perc-sw/phyduino_pico/docs/pdf/board/pinouts.pdf

# PHYDUINO PICO PIN OUTS

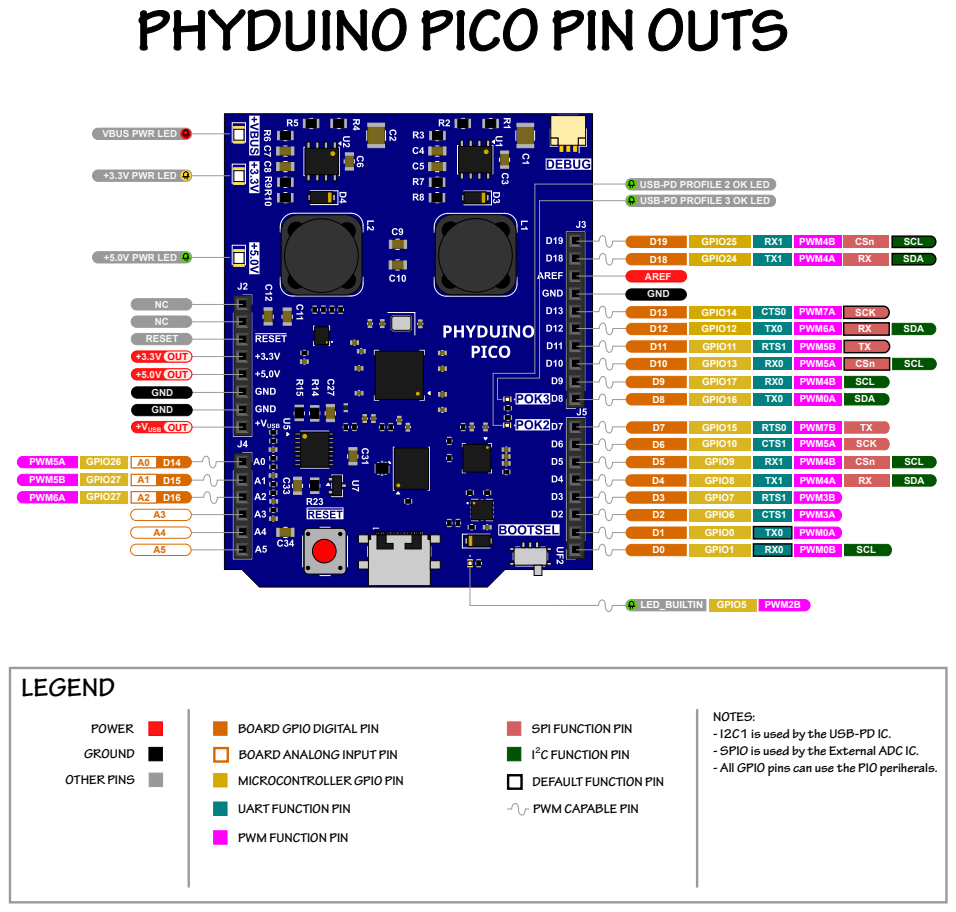
[picture p2: page 1]

USB-PD PROFILE 2 OK LED
USB-PD PROFILE 3 OK LED

NOTES:
- I2C1 is used by the USB-PD IC.
- SPI0 is used by the External ADC IC.
- All GPIO pins can use the PIO periherals.

BOARD GPIO DIGITAL PIN

BOARD ANALONG INPUT PIN
MICROCONTROLLER GPIO PIN
