perc-sw/phyduino_pico/docs/pdf/board/phyduino_pico_schematic.pdf

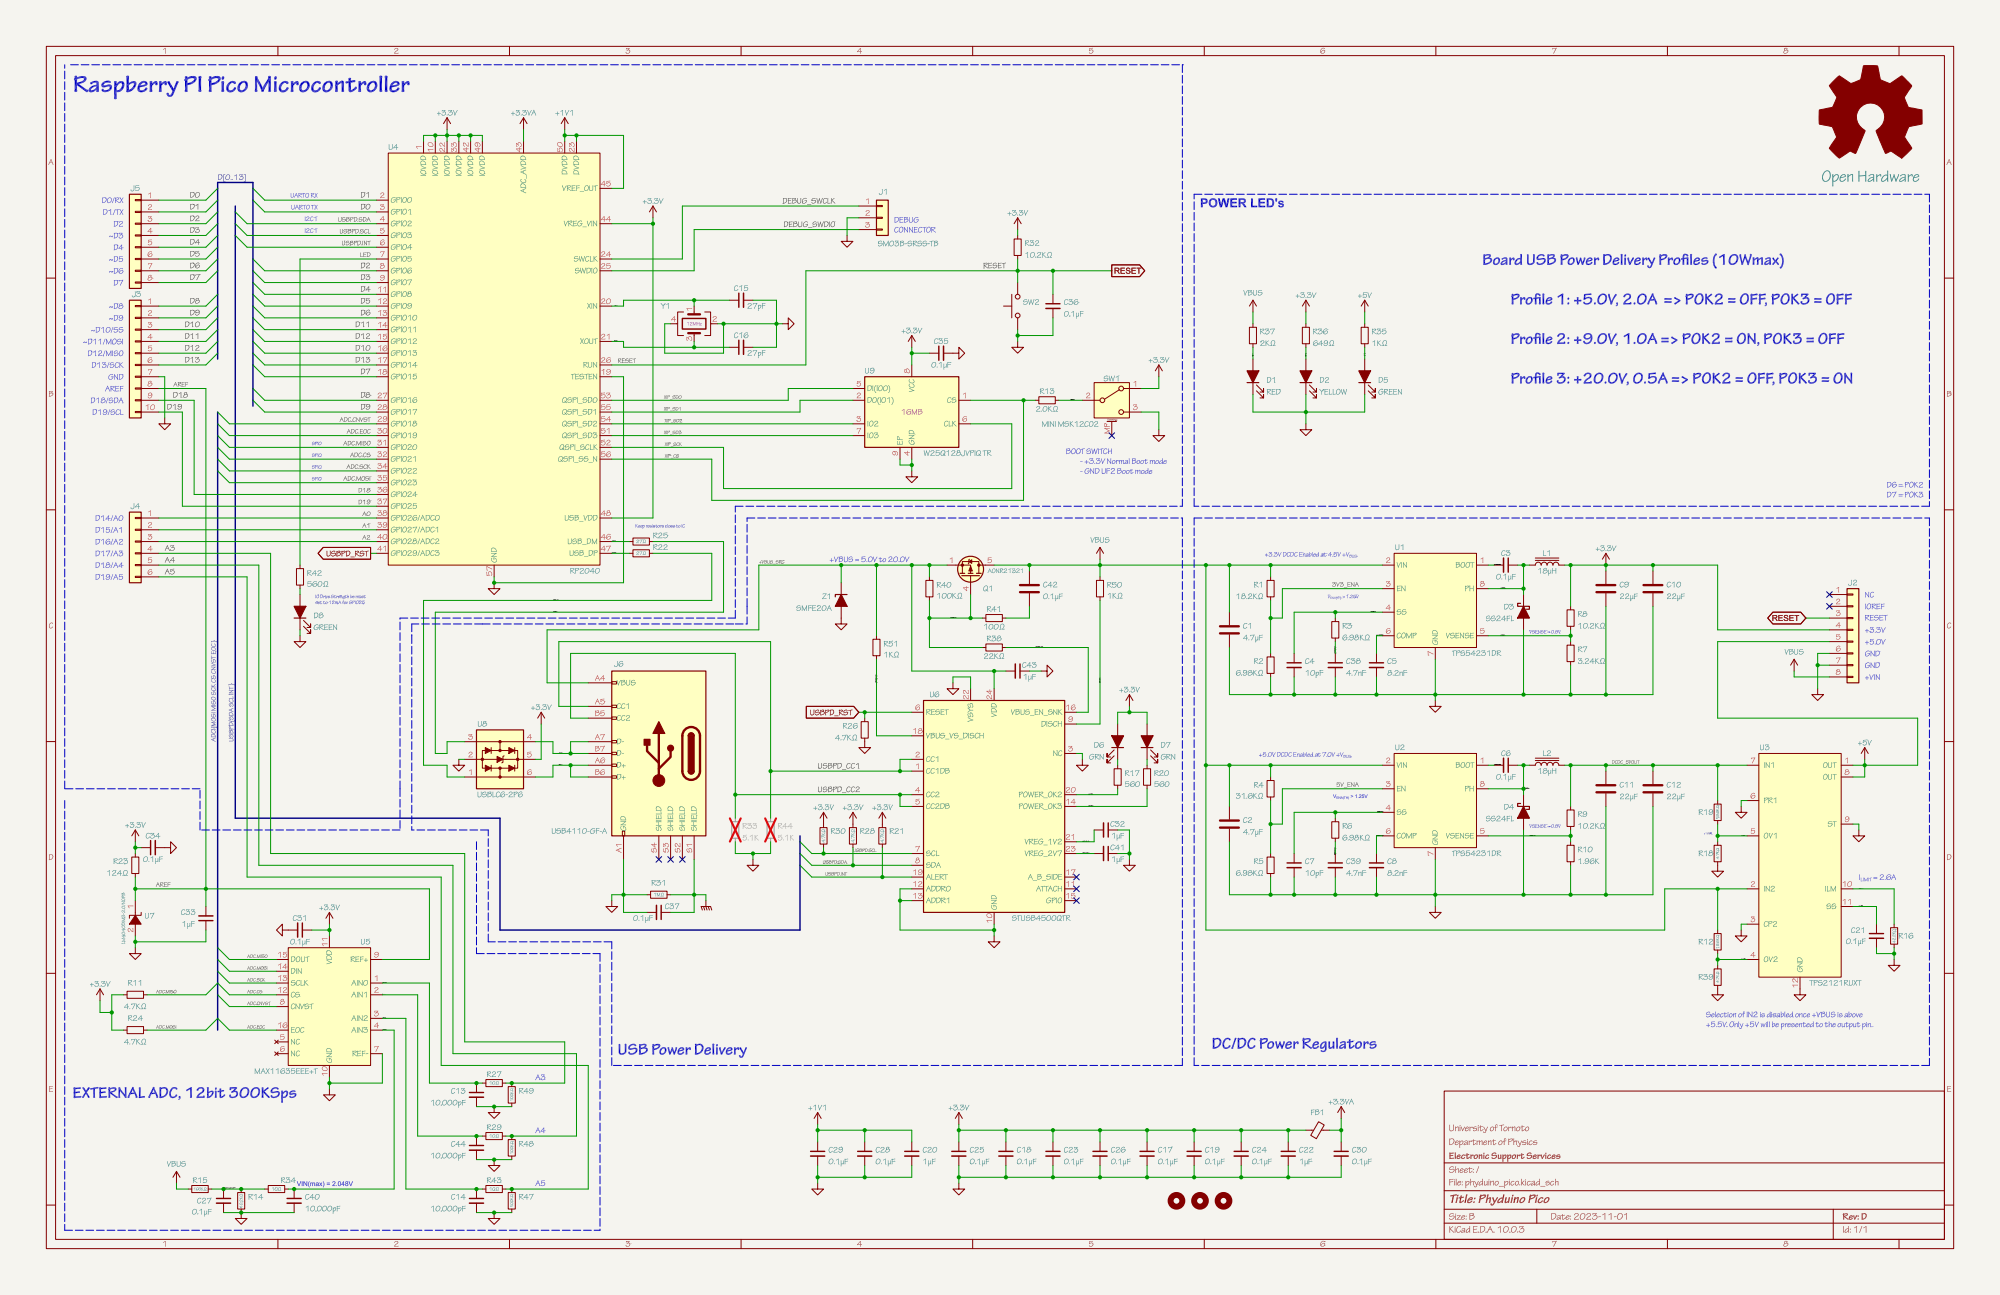
[picture p3: page 1]
