perc-sw/phyduino_pico/docs/pdf/board/phyduino_pico_pcb_back.pdf

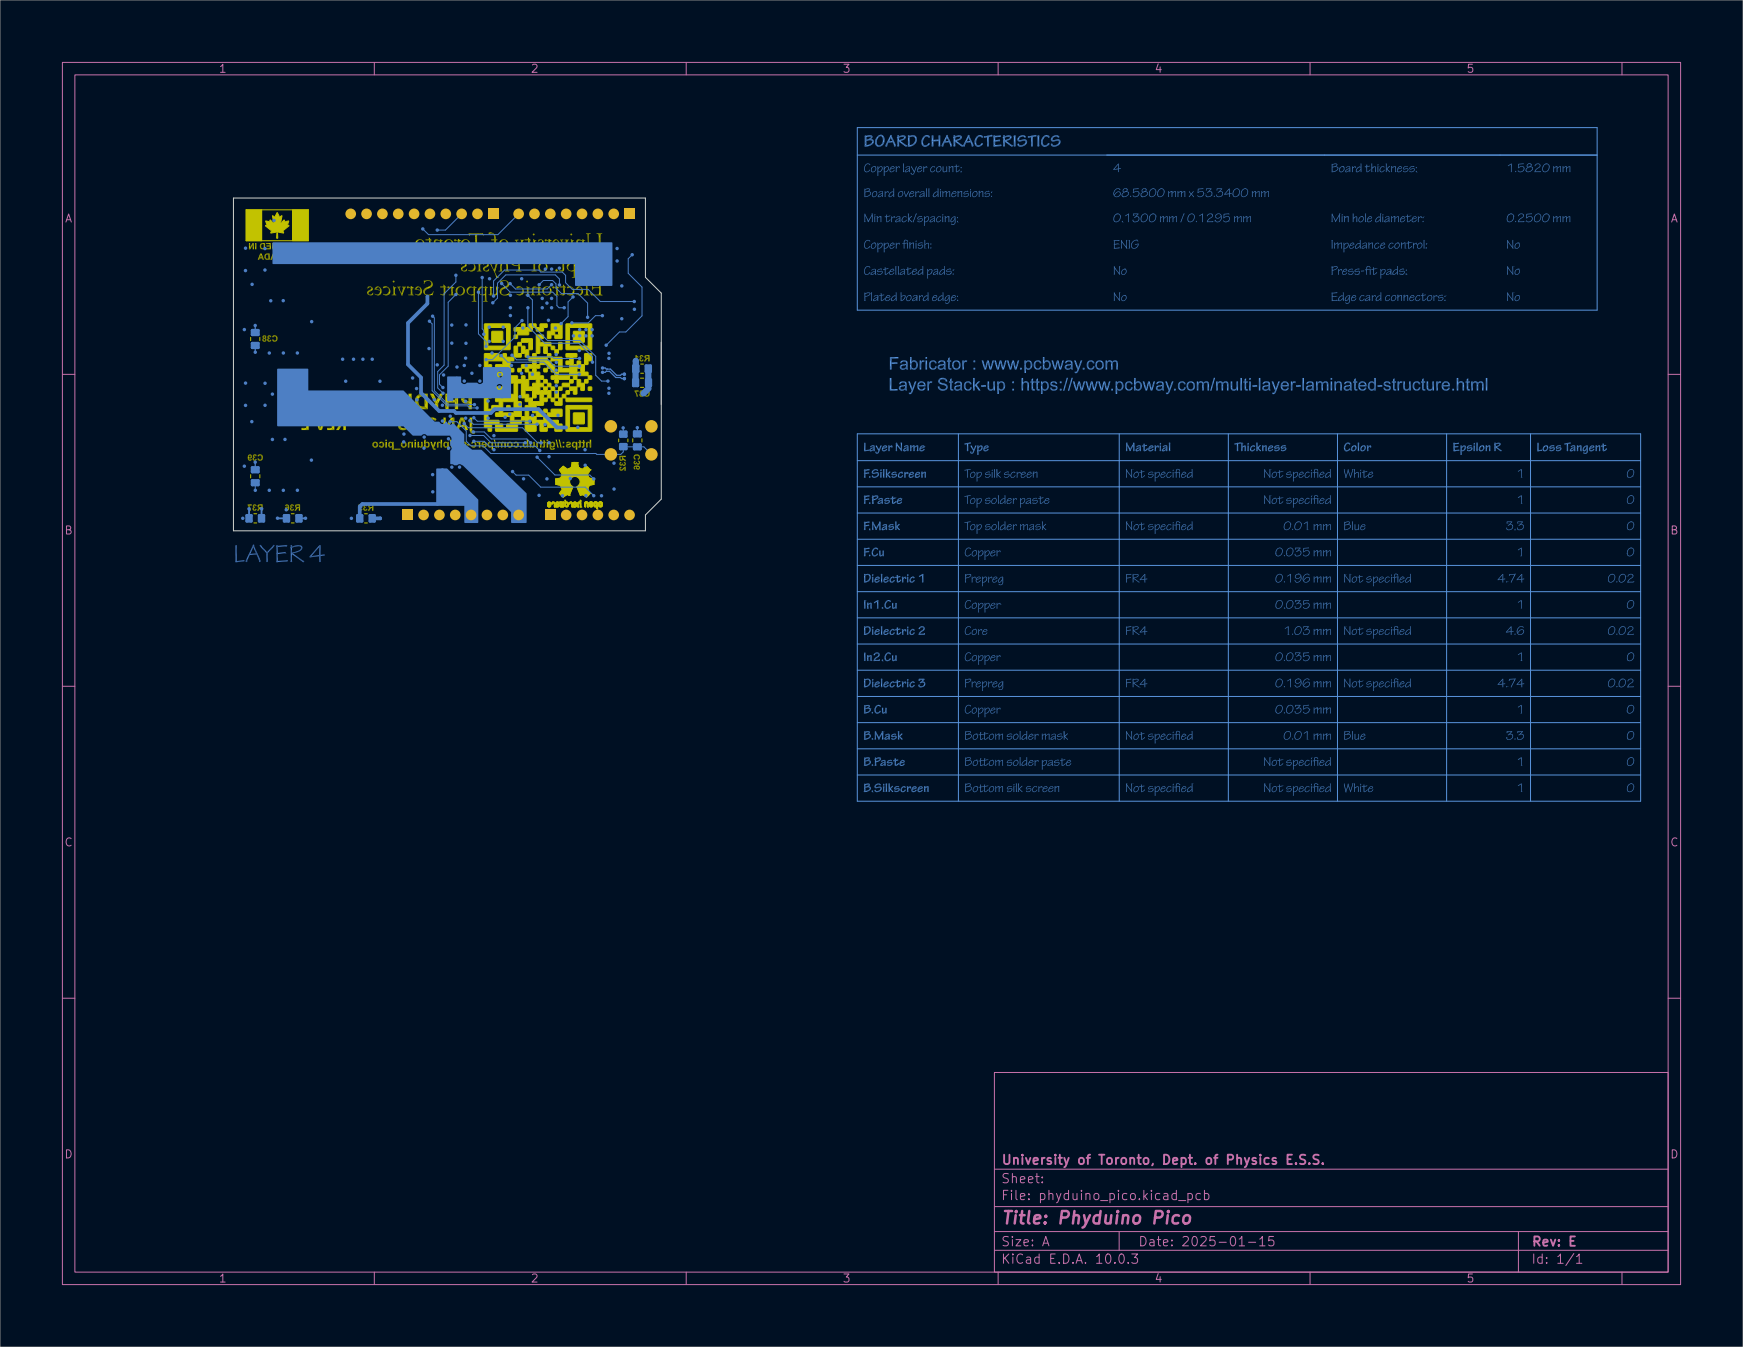
[picture p4: page 1]
