perc-sw/phyduino_pico/docs/pdf/board/phyduino_pico_pcb_front.pdf

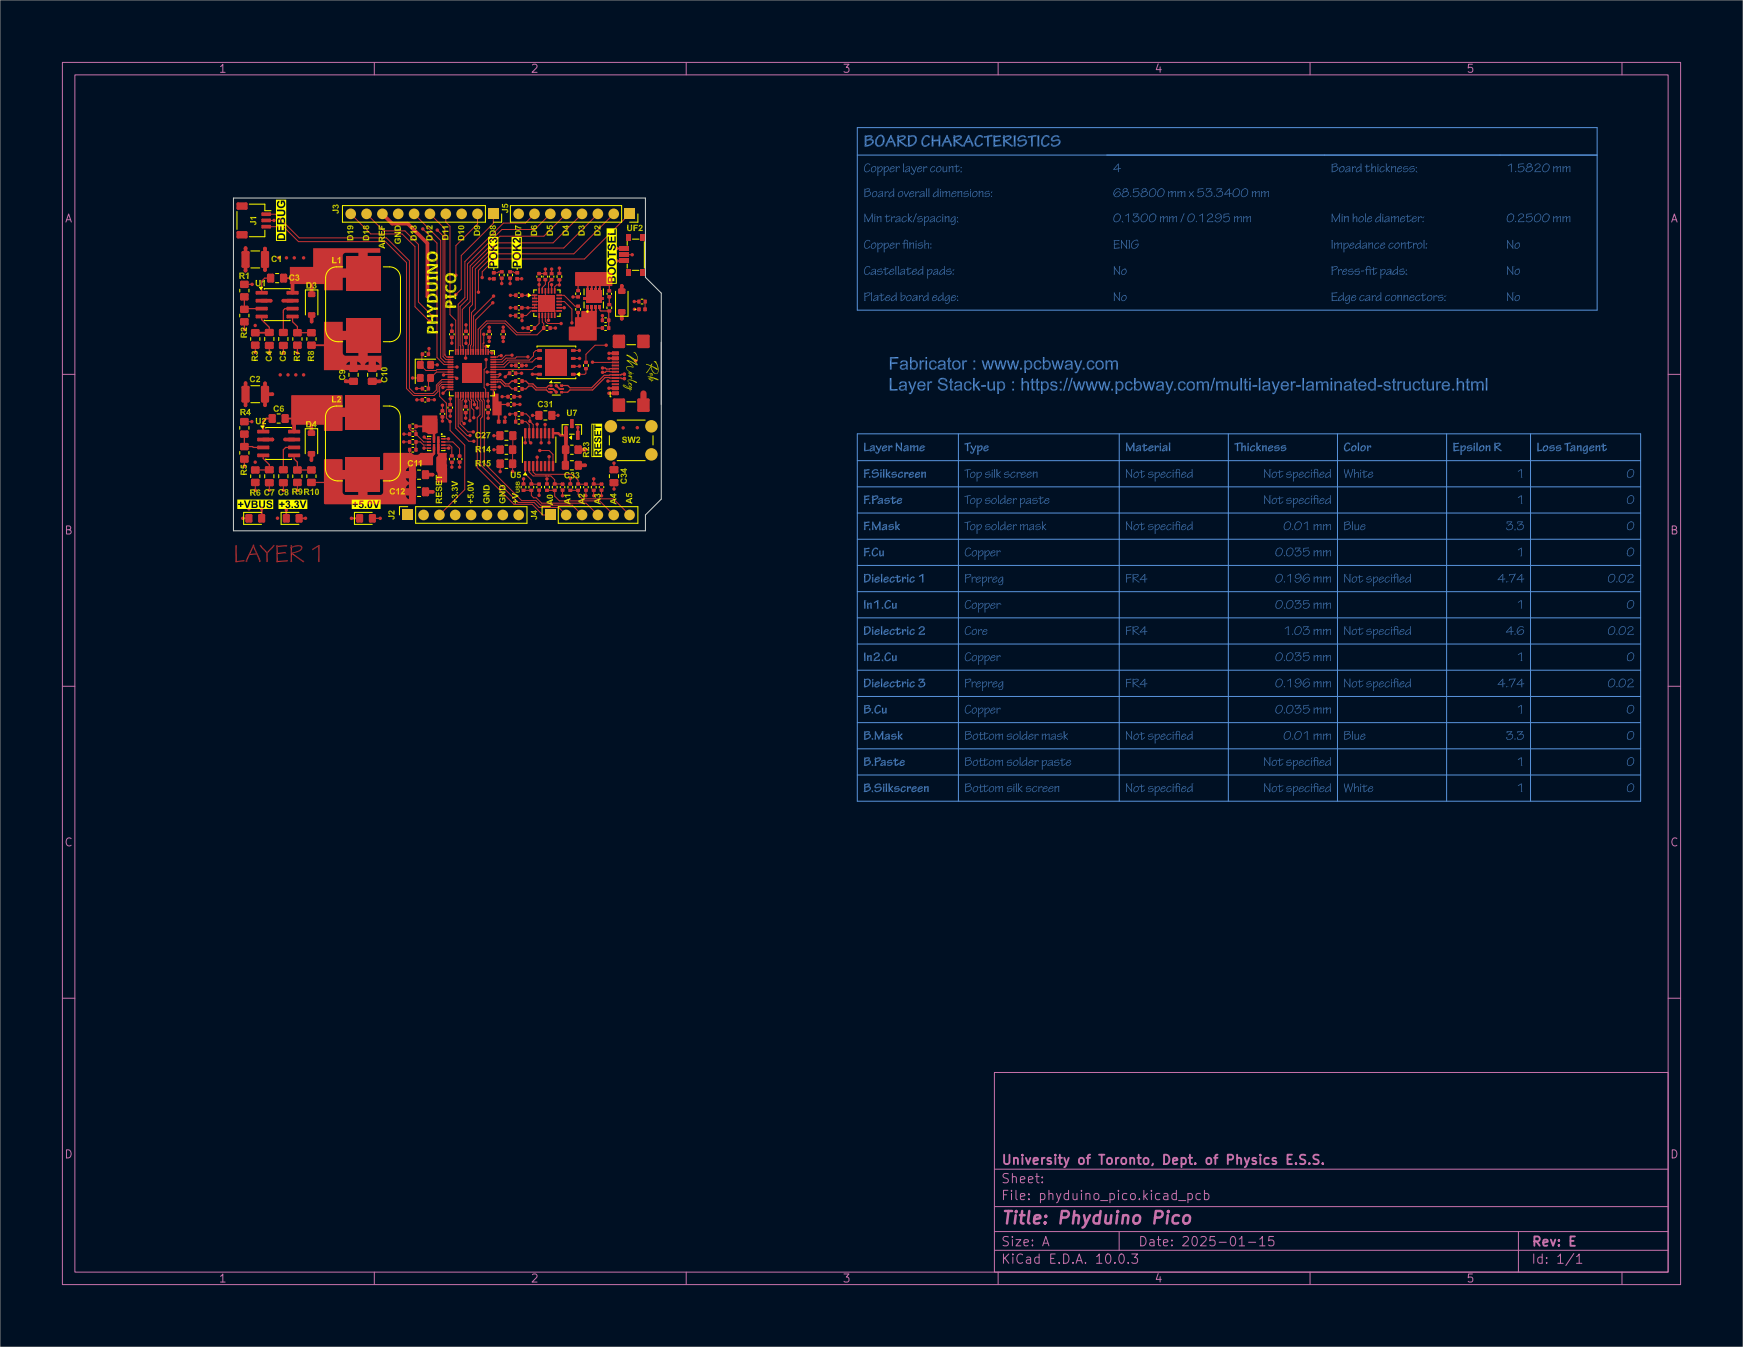
[picture p5: page 1]
