perc-sw/phyduino_pico/docs/pdf/board/phyduino_pico_pcb_inner1.pdf

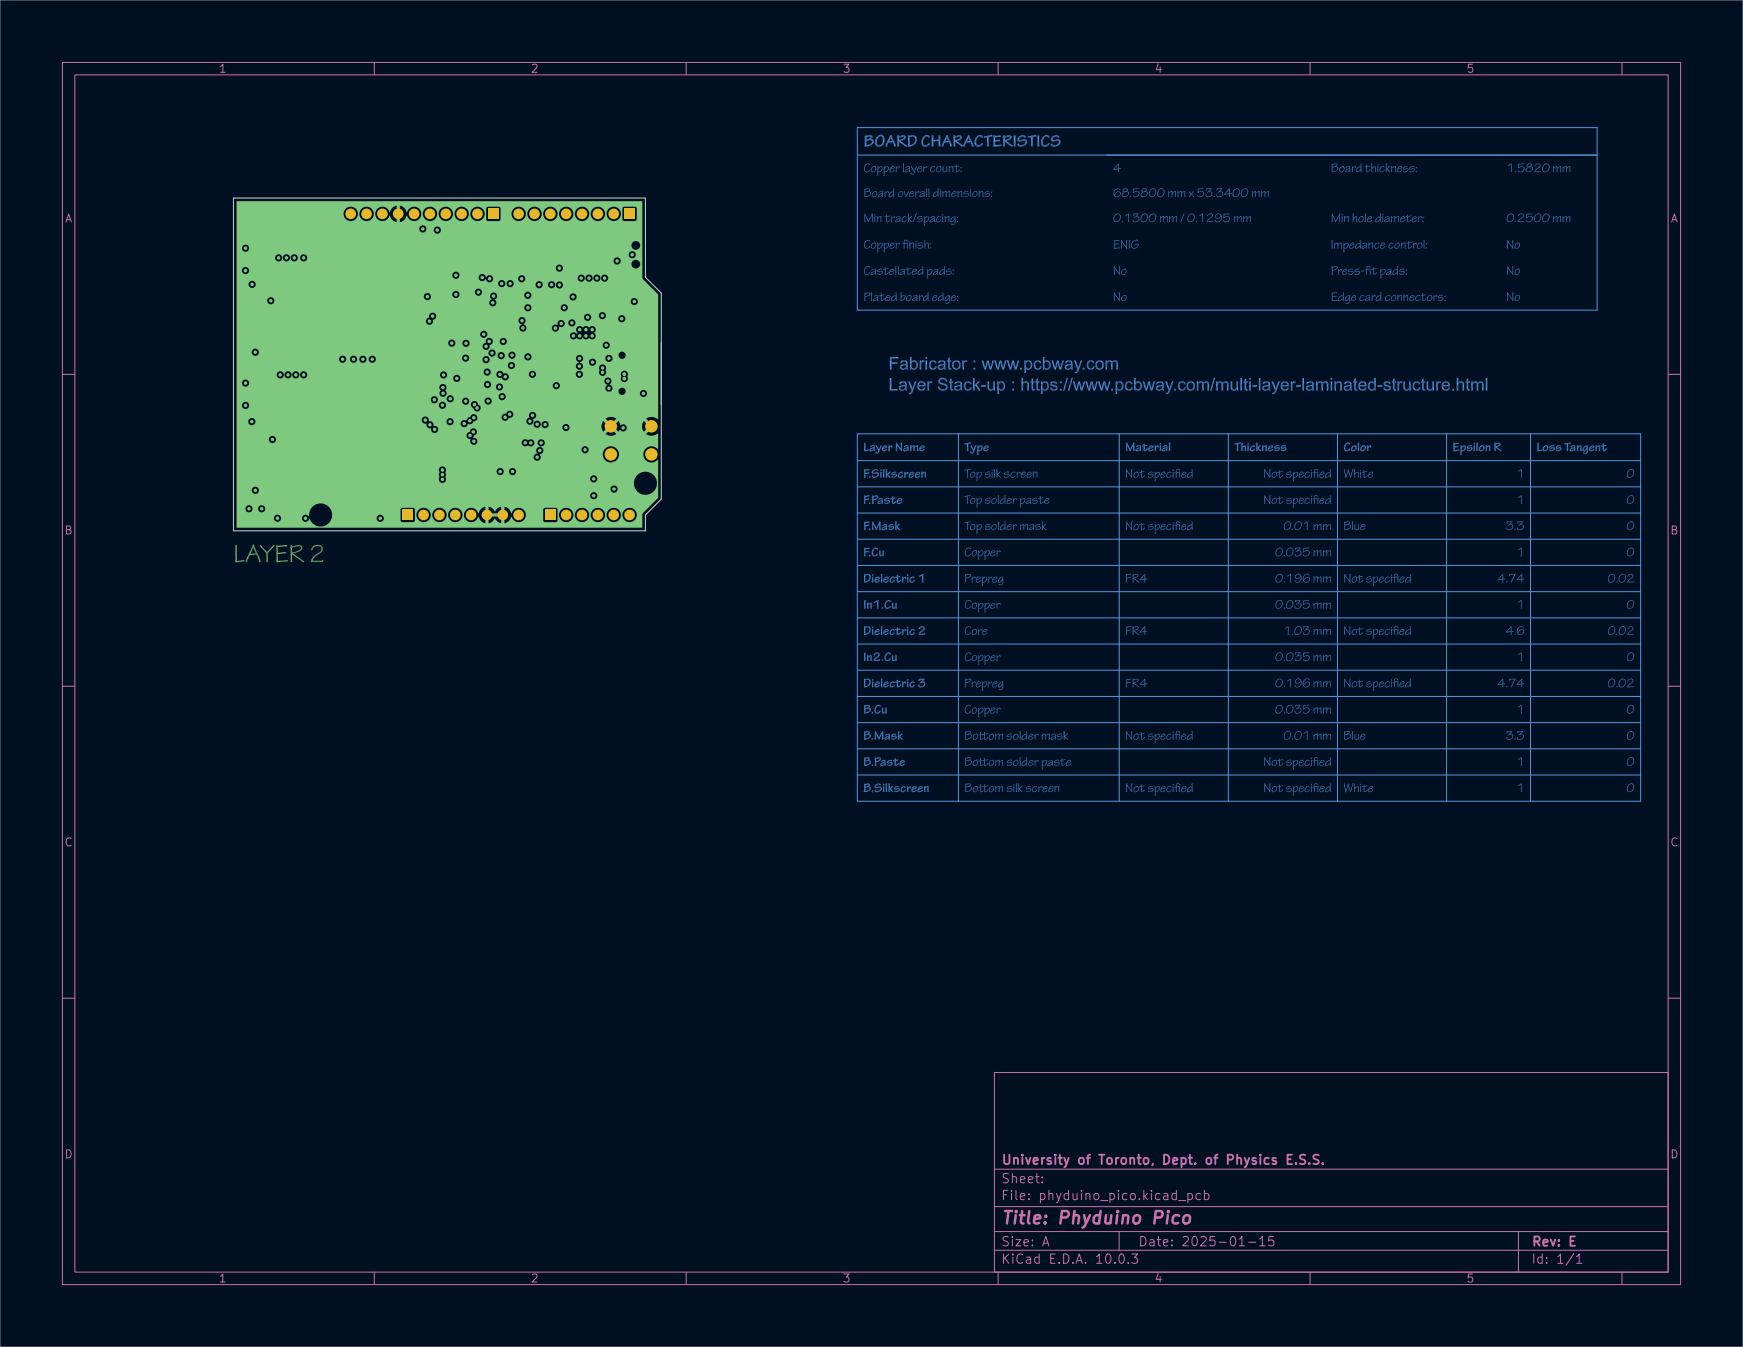
[picture p6: page 1]
