perc-sw/phyduino_pico/docs/pdf/board/phyduino_pico_pcb_inner2.pdf

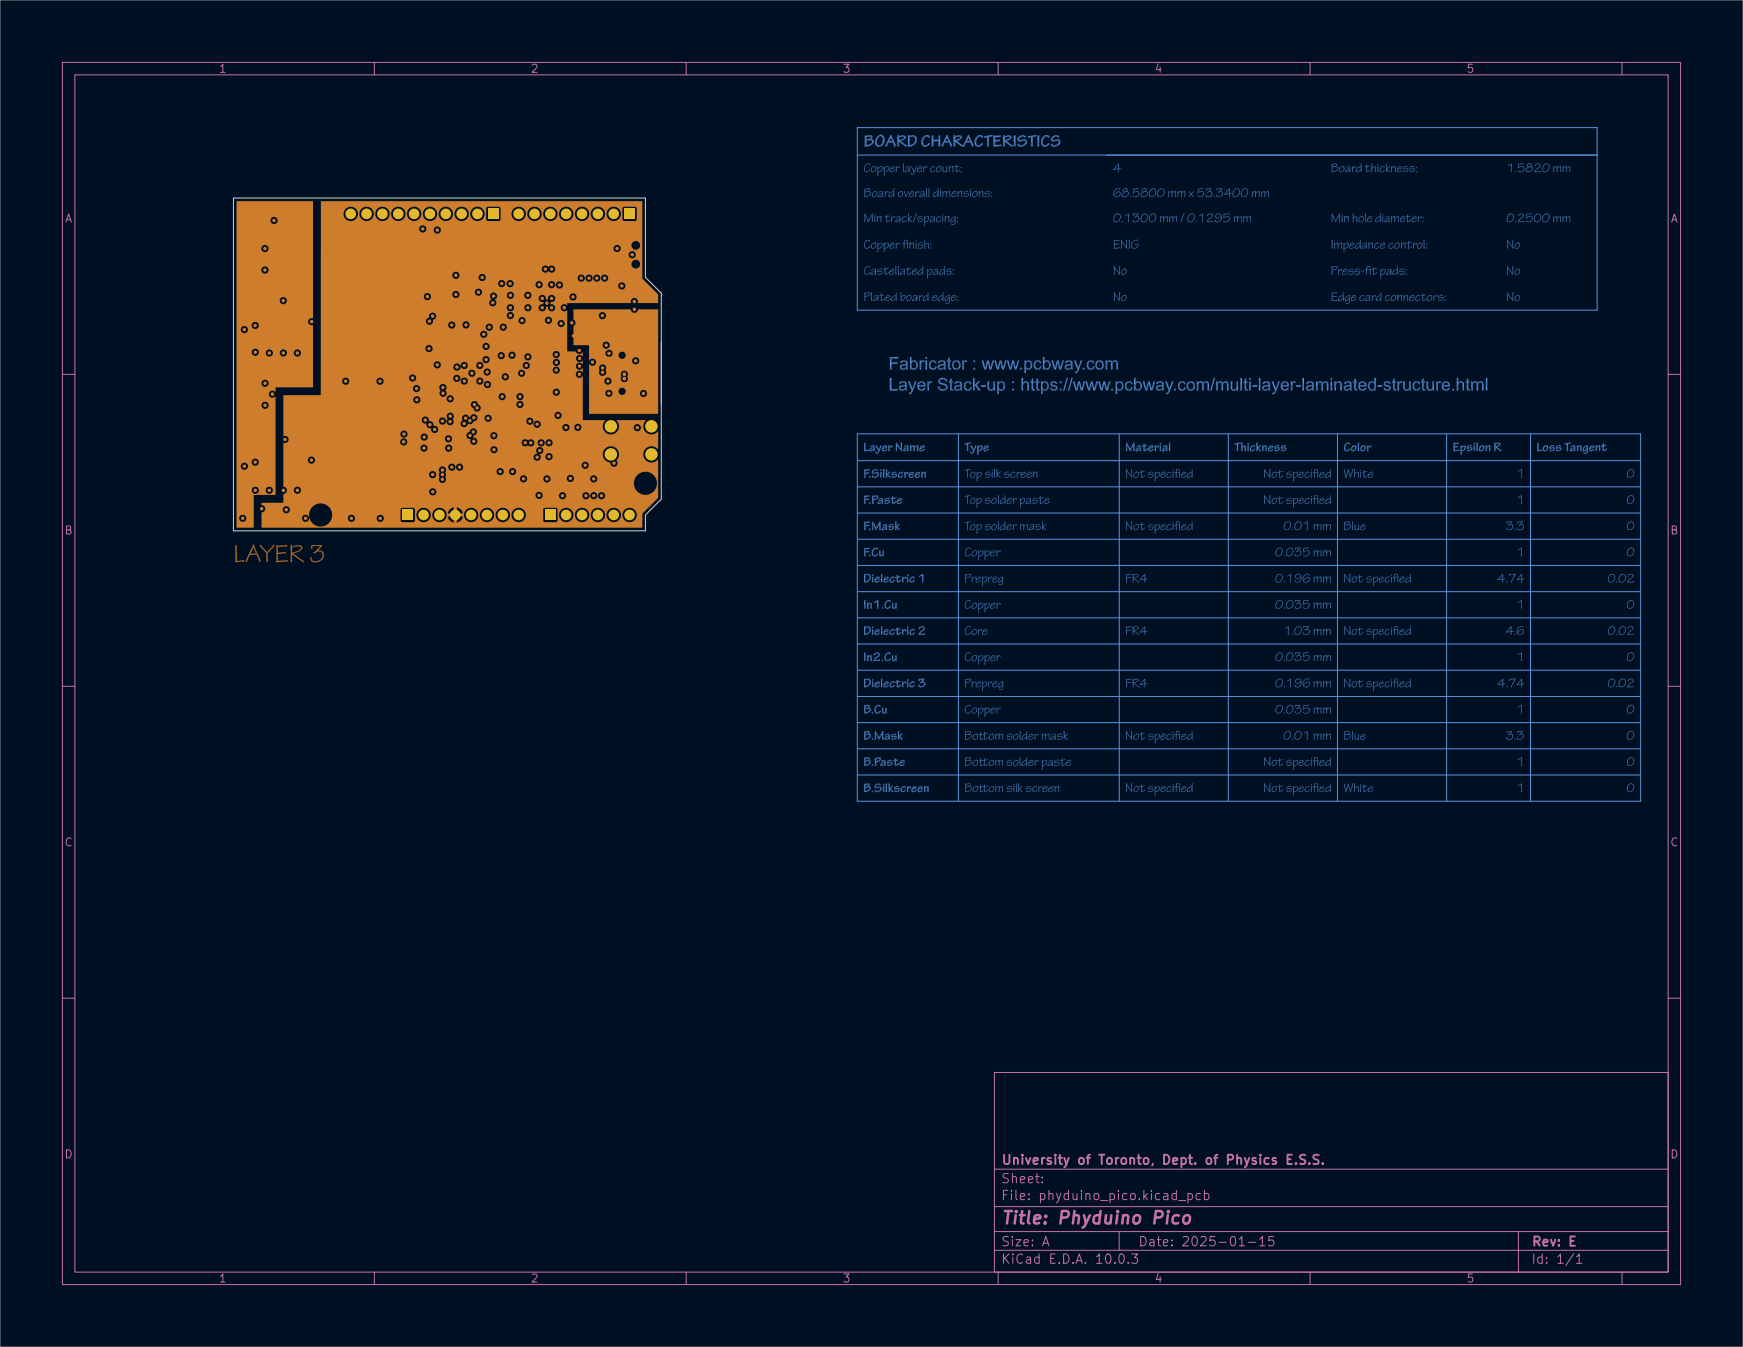
[picture p7: page 1]
