perc-sw/phyduino_pico/phyduino_pico.kicad_sch

## KiCad design phyduino_pico.kicad_sch (2026-06-09)

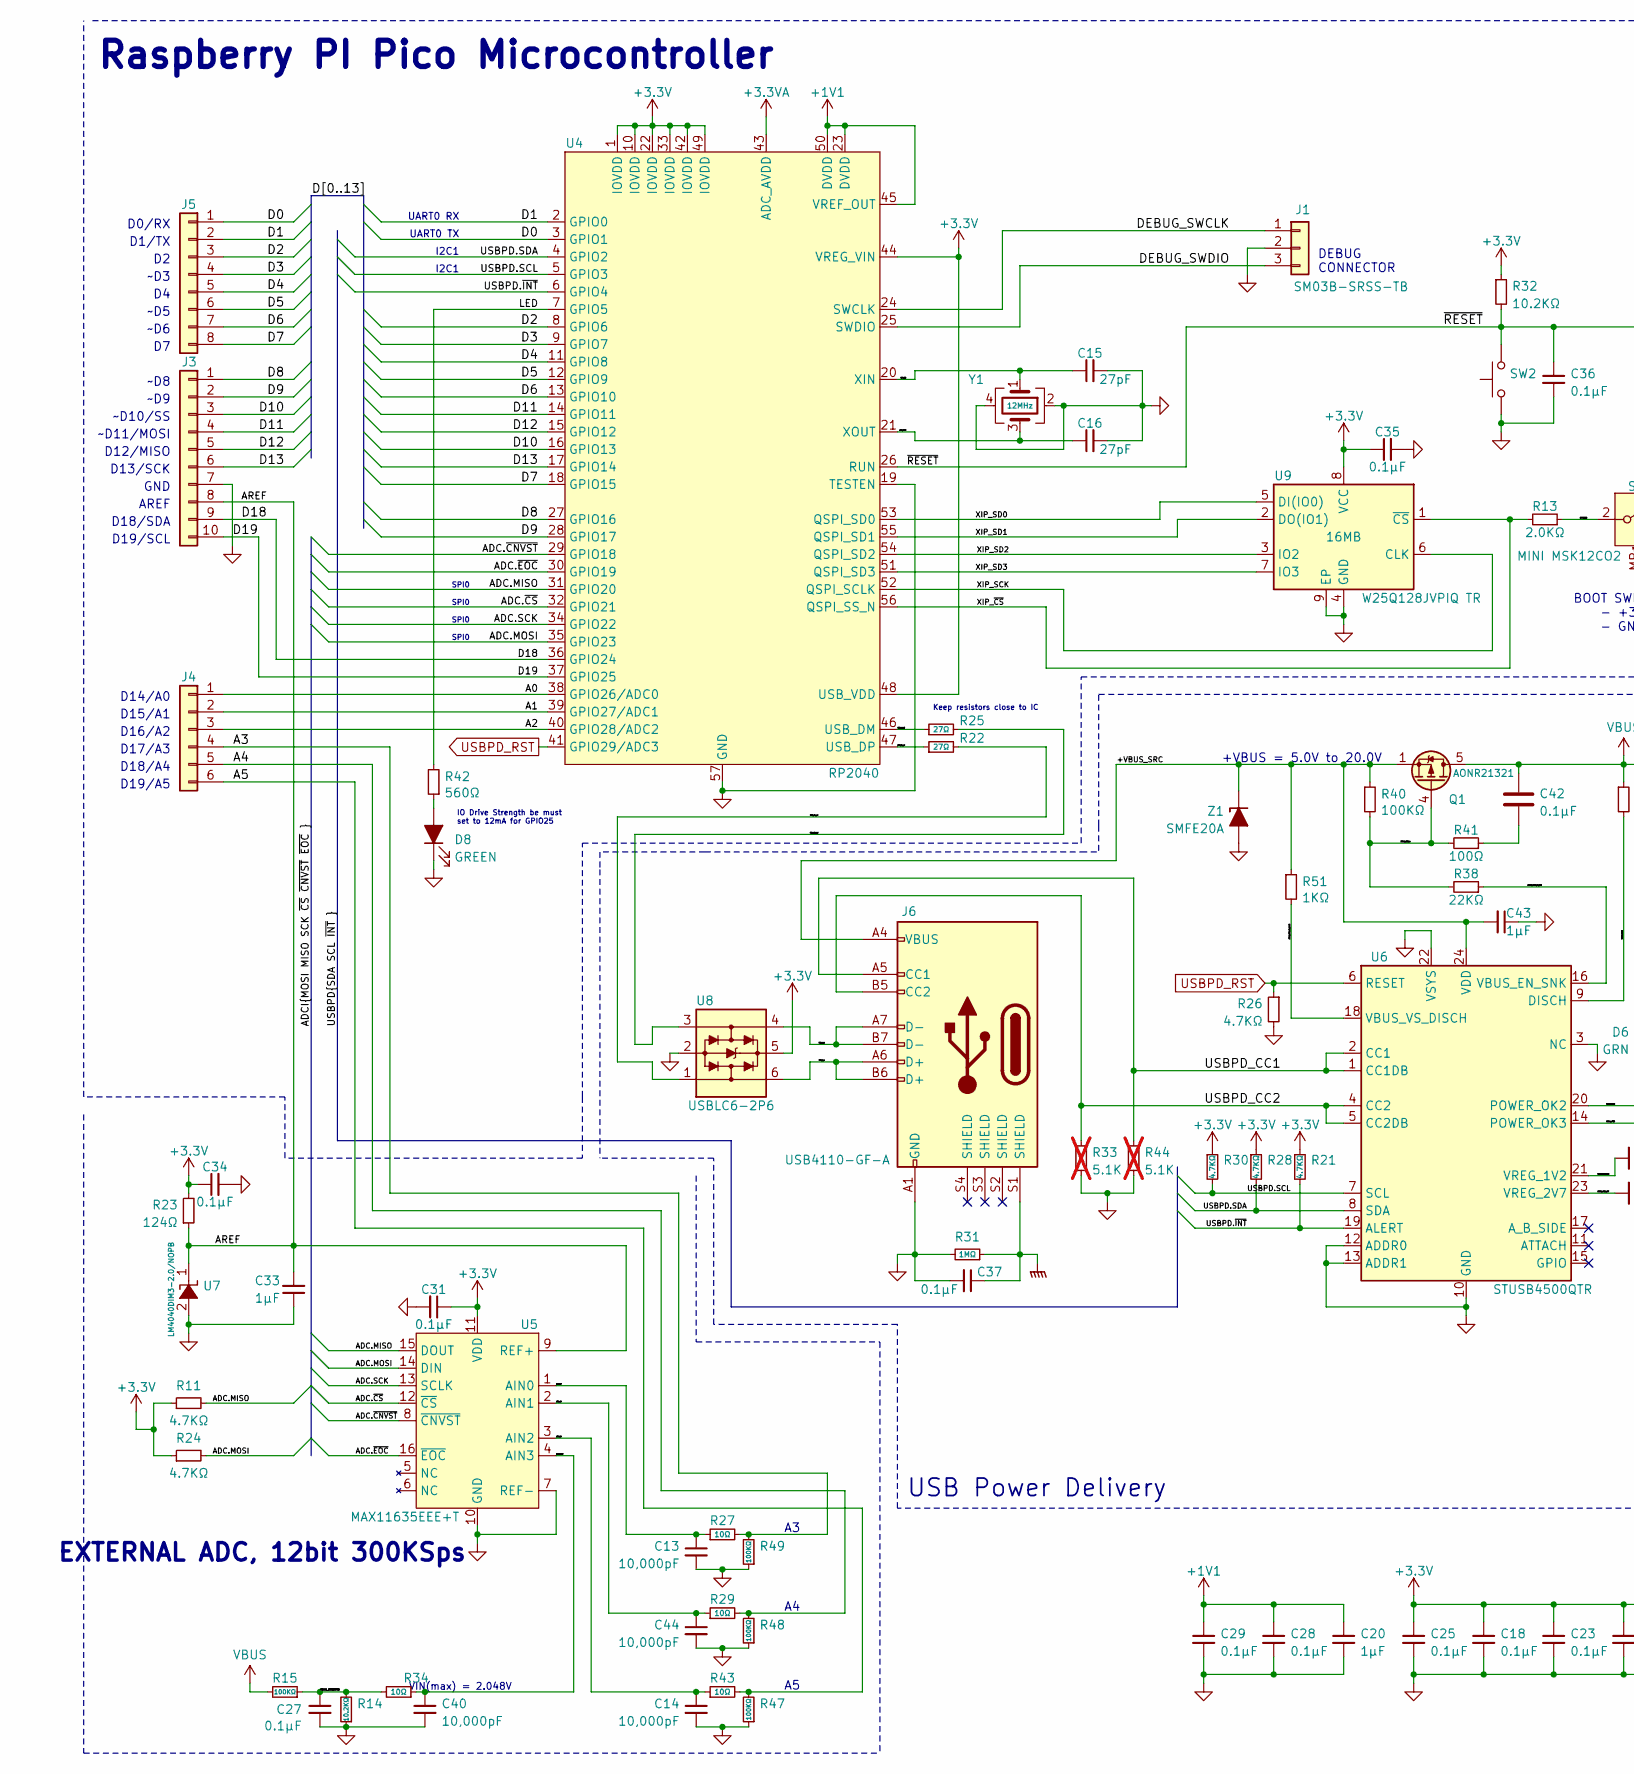
[picture p8: schematic phyduino_pico.kicad_sch, part in row 1, column 1]

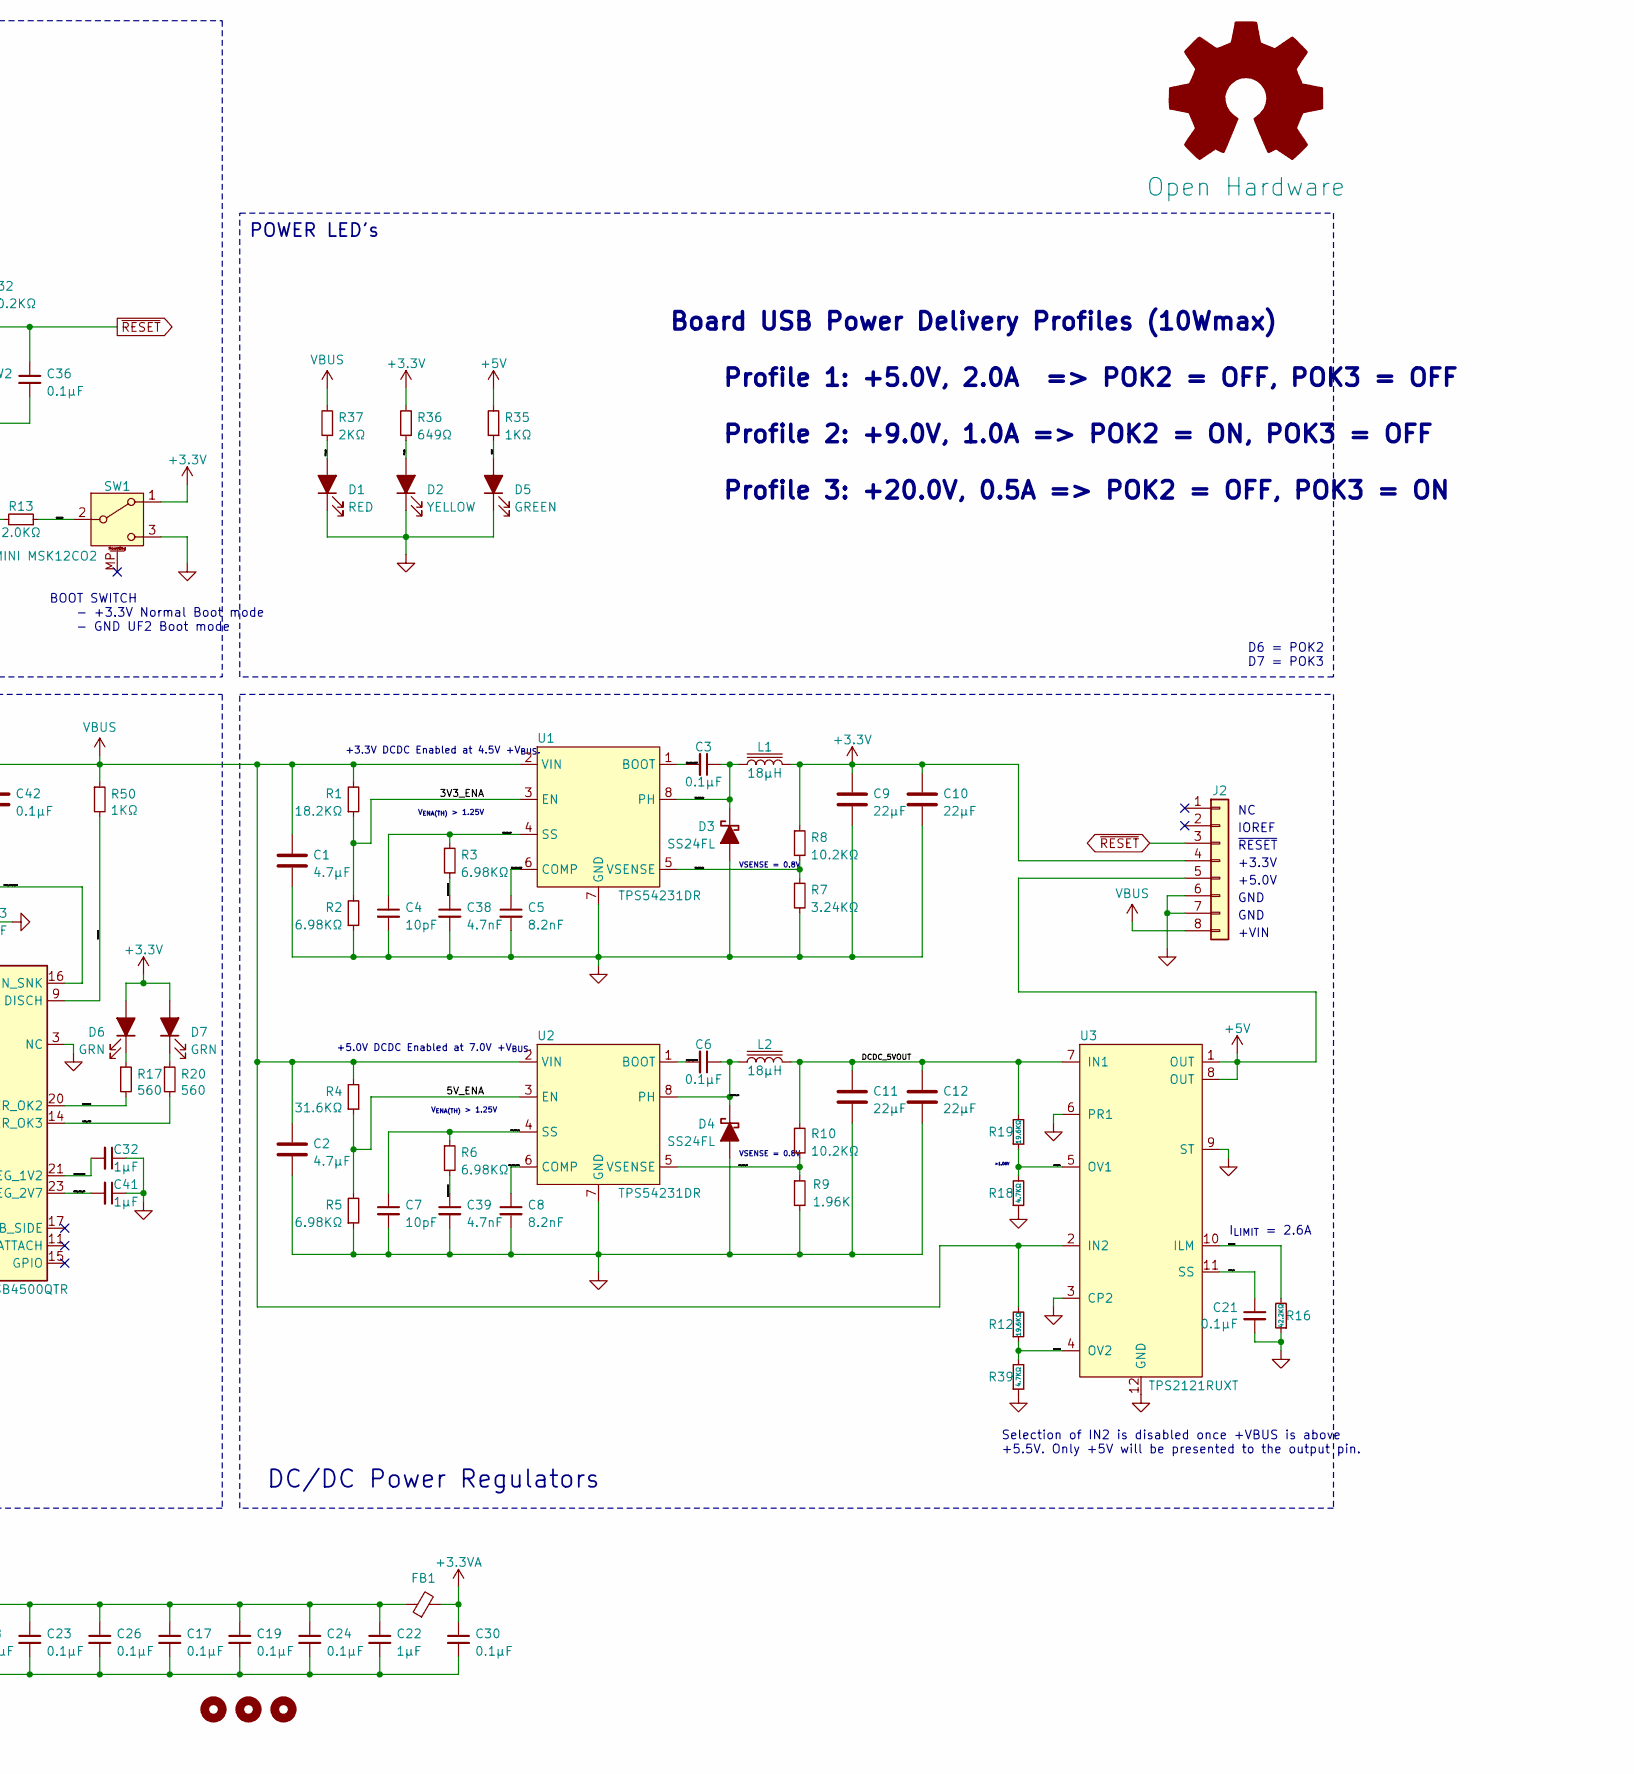
[picture p9: schematic phyduino_pico.kicad_sch, part in row 1, column 2]

Parts:
C1, C2: 4.7µF; C_1210_3225Metric_Pad1.33x2.70mm_HandSolder
C3, C6, C27, C31, C34, C36, C37: 0.1µF; C_0805_2012Metric_Pad1.18x1.45mm_HandSolder
C4, C7: 10pF; C_0805_2012Metric_Pad1.18x1.45mm_HandSolder
C5, C8: 8.2nF; C_0805_2012Metric_Pad1.18x1.45mm_HandSolder
C9, C10, C11, C12: 22µF; C_0805_2012Metric_Pad1.18x1.45mm_HandSolder
C13, C14, C40, C44: 10,000pF; C_0402_1005Metric
C15, C16: 27pF; C_0402_1005Metric
C17, C18, C19, C21, C23, C24, C25, C26, C28, C29, C30, C35, C42: 0.1µF; C_0402_1005Metric
C20, C22, C32, C41, C43: 1µF; C_0402_1005Metric
C33: 1µF; C_0805_2012Metric_Pad1.18x1.45mm_HandSolder
C38, C39: 4.7nF; C_0805_2012Metric_Pad1.18x1.45mm_HandSolder
D1: RED; LED_0805_2012Metric_Pad1.15x1.40mm_HandSolder
D2: YELLOW; LED_0805_2012Metric_Pad1.15x1.40mm_HandSolder
D3, D4: SS24FL; D_SOD-123
D5: GREEN; LED_0805_2012Metric_Pad1.15x1.40mm_HandSolder
D6, D7: GRN; LED_0402_1005Metric
D8: GREEN; LED_0402_1005Metric
DRAW1: Open Hardware; OSHW-Logo2_9.8x8mm_SilkScreen
FB1: BLM15AG221SH1D; L_0402_1005Metric
H1, H3, H4: MountingHole; MountingHole_3.2mm_M3
J1: SM03B-SRSS-TB; JST_SH_SM03B-SRSS-TB_1x03-1MP_P1.00mm_Horizontal
J2, J5: Conn_01x08; PinSocket_1x08_P2.54mm_Vertical
J3: Conn_01x10; PinSocket_1x10_P2.54mm_Vertical
J4: Conn_01x06; PinSocket_1x06_P2.54mm_Vertical
J6: USB4110-GF-A; GCT-USBC-GCT_USB4110
L1, L2: 18µH; MSS1246_Handsolder
Q1: AONR21321; AONR21321_DFN_3x3
R1: 18.2KΩ; R_0805_2012Metric_Pad1.20x1.40mm_HandSolder
R2, R3, R5, R6: 6.98KΩ; R_0805_2012Metric_Pad1.20x1.40mm_HandSolder
R4: 31.6KΩ; R_0805_2012Metric_Pad1.20x1.40mm_HandSolder
R7: 3.24KΩ; R_0805_2012Metric_Pad1.20x1.40mm_HandSolder
R8, R10, R14, R32: 10.2KΩ; R_0805_2012Metric_Pad1.20x1.40mm_HandSolder
R9: 1.96K; R_0805_2012Metric_Pad1.20x1.40mm_HandSolder
R11, R18, R21, R24, R26, R28, R30, R39: 4.7KΩ; R_0402_1005Metric
R12, R19: 19.6KΩ; R_0402_1005Metric
R13: 2.0KΩ; R_0402_1005Metric
R15: 100KΩ; R_0805_2012Metric_Pad1.20x1.40mm_HandSolder
R16: 42.2KΩ; R_0402_1005Metric
R17, R20: 560; R_0402_1005Metric
R22, R25: 27Ω; R_0402_1005Metric
R23: 124Ω; R_0805_2012Metric_Pad1.20x1.40mm_HandSolder
R27, R29, R34, R43: 10Ω; R_0402_1005Metric
R31: 1MΩ; R_0805_2012Metric_Pad1.20x1.40mm_HandSolder
R33, R44: 5.1K; C_0402_1005Metric; not fitted
R35: 1KΩ; R_0805_2012Metric_Pad1.20x1.40mm_HandSolder
R36: 649Ω; R_0805_2012Metric_Pad1.20x1.40mm_HandSolder
R37: 2KΩ; R_0805_2012Metric_Pad1.20x1.40mm_HandSolder
R38: 22KΩ; R_0402_1005Metric
R40, R47, R48, R49: 100KΩ; R_0402_1005Metric
R41: 100Ω; R_0402_1005Metric
R42: 560Ω; R_0402_1005Metric
R50, R51: 1KΩ; R_0402_1005Metric
SW1: MINI MSK12CO2; Switch_Slide_ShouHan_MINI_MSK12CO2
SW2: TL1105F250Q; SW_PUSH_6mm_H4.3mm
U1, U2: TPS54231DR; SOIC-8_3.9x4.9mm_P1.27mm
U3: TPS2121RUXT; VQFN-HR-12
U4: RP2040; QFN-56-1EP_7x7mm_P0.4mm_EP3.2x3.2mm
U5: MAX11635EEE+T; QSOP-16_3.9x4.9mm_P0.635mm
U6: STUSB4500QTR; QFN-24-1EP_4x4mm_P0.5mm_EP2.7x2.7mm
U7: LM4040DIM3-2.0/NOPB; SOT-23
U8: USBLC6-2P6; SOT-666
U9: W25Q128JVPIQ TR; WSON-8-1EP_6x5mm_P1.27mm_EP3.4x4.3mm
Y1: H130B-12.000-18-3030-TR; Oscillator_SMD_Abracon_ASE-4Pin_3.2x2.5mm
Z1: SMFE20A; D_SOD-123

Connections:
3V3_DCDC_BOOST: C3.2, U1.1 (BOOT)
3V3_DCDC_COMP: C5.1, U1.6 (COMP)
3V3_DCDC_FB: R7.1, R8.2, U1.5 (VSENSE)
3V3_DCDC_SS: C4.1, R3.1, U1.4 (SS)
3V3_DCDC_SS_CAP: C38.1, R3.2
3V3_DCDC_SW: C3.1, D3.1 (K), L1.1, U1.8 (PH)
3V3_ENA: R1.1, R2.2, U1.3 (EN)
3V3_LED: D2.2 (A), R36.1
5V0_DCDC_BOOST: C6.2, U2.1 (BOOT)
5V0_DCDC_COMP: C8.1, U2.6 (COMP)
5V0_DCDC_FB: R9.1, R10.2, U2.5 (VSENSE)
5V0_DCDC_SS: C7.1, R6.1, U2.4 (SS)
5V0_DCDC_SS_CAP: C39.1, R6.2
5V0_DCDC_SW: C6.1, D4.1 (K), L2.1, U2.8 (PH)
5V_ENA: R4.1, R5.2, U2.3 (EN)
5V_LED: D5.2 (A), R35.1
+1V1: C20.1, C28.1, C29.1, U4.23 (DVDD), U4.45 (VREF_OUT), U4.50 (DVDD)
+3.3V: C9.1, C10.1, C17.1, C18.1, C19.1, C22.1, C23.1, C24.1, C25.1, C26.1, C31.1, C34.1, C35.1, D6.2 (A), D7.2 (A), FB1.1, J2.4, L1.2, R8.1, R11.1, R21.1, R23.2, R24.1, R28.1, R30.1, R32.1, R36.2, SW1.1 (A), U4.1 (IOVDD), U4.10 (IOVDD), U4.22 (IOVDD), U4.33 (IOVDD), U4.42 (IOVDD), U4.44 (VREG_VIN), U4.48 (USB_VDD), U4.49 (IOVDD), U5.11 (VDD), U8.5 (VBUS), U9.8 (VCC)
+3.3VA: C30.1, FB1.2, U4.43 (ADC_AVDD)
+5V: J2.5, R35.2, U3.1 (OUT), U3.8 (OUT)
+VBUS_SRC: C43.2, J6.A4 (VBUS), J6.A9 (VBUS), J6.B4 (VBUS), J6.B9 (VBUS), Q1.1 (S), Q1.2 (S), Q1.3 (S), R40.1, R51.1, U6.24 (VDD), Z1.1 (K)
A0: J4.1, U4.38 (GPIO26/ADC0)
A1: J4.2, U4.39 (GPIO27/ADC1)
A2: J4.3, U4.40 (GPIO28/ADC2)
A3: J4.4, R27.2, R49.2
A4: J4.5, R29.2, R48.2
A5: J4.6, R43.2, R47.2
ADC.MISO: R11.2, U4.31 (GPIO20), U5.15 (DOUT)
ADC.MOSI: R24.2, U4.35 (GPIO23), U5.14 (DIN)
ADC.SCK: U4.34 (GPIO22), U5.13 (SCLK)
ADC.~CNVST: U4.29 (GPIO18), U5.8 (~CNVST)
ADC.~CS: U4.32 (GPIO21), U5.12 (~CS)
ADC.~EOC: U4.30 (GPIO19), U5.16 (~EOC)
AIN0_A3: C13.1, R27.1, U5.1 (AIN0)
AIN1_A4: C44.1, R29.1, U5.2 (AIN1)
AIN2_A5: C14.1, R43.1, U5.3 (AIN2)
AIN3_VBUS: C40.1, R34.1, U5.4 (AIN3)
AREF: C33.2, J3.8, R23.1, U5.9 (REF+), U7.1 (K)
BOOTMODE: R13.1, SW1.2 (B)
CPU_XIN: C15.1, U4.20 (XIN), Y1.1
CPU_XOUT: C16.1, U4.21 (XOUT), Y1.3
D0: J5.1, U4.3 (GPIO1)
D1: J5.2, U4.2 (GPIO0)
D2: J5.3, U4.8 (GPIO6)
D3: J5.4, U4.9 (GPIO7)
D4: J5.5, U4.11 (GPIO8)
D5: J5.6, U4.12 (GPIO9)
D6: J5.7, U4.13 (GPIO10)
D7: J5.8, U4.18 (GPIO15)
D8: J3.1, U4.27 (GPIO16)
D9: J3.2, U4.28 (GPIO17)
D10: J3.3, U4.16 (GPIO13)
D11: J3.4, U4.14 (GPIO11)
D12: J3.5, U4.15 (GPIO12)
D13: J3.6, U4.17 (GPIO14)
D18: J3.9, U4.36 (GPIO24)
D19: J3.10, U4.37 (GPIO25)
DCDC_5VOUT: C11.1, C12.1, L2.2, R10.1, R19.2, U3.7 (IN1)
DEBUG_SWCLK: J1.1, U4.24 (SWCLK)
DEBUG_SWDIO: J1.3, U4.25 (SWDIO)
GND: C1.1, C2.1, C4.2, C5.2, C7.2, C8.2, C9.2, C10.2, C11.2, C12.2, C13.2, C14.2, C15.2, C16.2, C17.2, C18.2, C19.2, C20.2, C21.2, C22.2, C23.2, C24.2, C25.2, C26.2, C27.2, C28.2, C29.2, C30.2, C31.2, C32.1, C33.1, C34.2, C35.2, C36.2, C37.2, C38.2, C39.2, C40.2, C41.1, C43.1, C44.2, D1.1 (K), D2.1 (K), D3.2 (A), D4.2 (A), D5.1 (K), D8.1 (K), J1.2, J2.6, J2.7, J3.7, J6.A1 (GND), J6.A12 (GND), J6.B1 (GND), J6.B12 (GND), R2.1, R5.1, R7.2, R9.2, R14.1, R16.1, R18.1, R26.2, R31.2, R33.2, R39.1, R44.2, R47.1, R48.1, R49.1, SW1.3 (C), SW2.1, U1.7 (GND), U2.7 (GND), U3.3 (CP2), U3.6 (PR1), U3.9 (ST), U3.12 (GND), U4.19 (TESTEN), U4.57 (GND), U5.7 (REF-), U5.10 (GND), U6.3 (NC), U6.10 (GND), U6.12 (ADDR0), U6.13 (ADDR1), U6.22 (VSYS), U6.25 (GND), U7.2 (A), U8.2 (GND), U9.4 (GND), U9.9 (EP), Y1.2, Y1.4, Z1.2 (A)
GNDPWR: C37.1, J6.S1 (SHIELD), R31.1
LED: R42.2, U4.7 (GPIO5)
unnamed: C42.1, R41.1
unnamed: D6.1 (K), R17.1
unnamed: D7.1 (K), R20.1
unnamed: D8.2 (A), R42.1
PMUX_LIM: R16.2, U3.10 (ILM)
PMUX_OV1: R18.2, R19.1, U3.5 (OV1)
PMUX_OV2: R12.1, R39.2, U3.4 (OV2)
PMUX_SS: C21.1, U3.11 (SS)
USBPD.SCL: R30.2, U4.5 (GPIO3), U6.7 (SCL)
USBPD.SDA: R28.2, U4.4 (GPIO2), U6.8 (SDA)
USBPD.~INT: R21.2, U4.6 (GPIO4), U6.19 (ALERT)
USBPD_CC1: J6.A5 (CC1), R44.1, U6.1 (CC1DB), U6.2 (CC1)
USBPD_CC2: J6.B5 (CC2), R33.1, U6.4 (CC2), U6.5 (CC2DB)
USBPD_DISCH: R50.2, U6.9 (DISCH)
USBPD_POK2: R17.2, U6.20 (POWER_OK2)
USBPD_POK3: R20.2, U6.14 (POWER_OK3)
USBPD_RST: R26.1, U4.41 (GPIO29/ADC3), U6.6 (RESET)
USBPD_SINK_G: Q1.4 (G), R38.2, R40.2, R41.2
USBPD_VBUS_EN_SNK: R38.1, U6.16 (VBUS_EN_SNK)
USBPD_VBUS_VS_DISCH: R51.2, U6.18 (VBUS_VS_DISCH)
USBPD_VREG_1V2: C32.2, U6.21 (VREG_1V2)
USBPD_VREG_2V7: C41.2, U6.23 (VREG_2V7)
USB_D_N: J6.A7 (D-), J6.B7 (D-), U8.4 (I/O2)
USB_D_P: J6.A6 (D+), J6.B6 (D+), U8.6 (I/O1)
USB_R_D_N: R25.1, U4.46 (USB_DM)
USB_R_D_P: R22.1, U4.47 (USB_DP)
USB_SP_D_N: R25.2, U8.3 (I/O2)
USB_SP_D_P: R22.2, U8.1 (I/O1)
VBUS: C1.2, C2.2, C42.2, J2.8, Q1.5 (D), Q1.6 (D), Q1.7 (D), Q1.8 (D), Q1.9 (D), Q1.9_1 (D), Q1.9_2 (D), R1.2, R4.2, R12.2, R15.2, R37.2, R50.1, U1.2 (VIN), U2.2 (VIN), U3.2 (IN2)
VBUS_LED: D1.2 (A), R37.1
VBUS_MONITOR: C27.1, R14.2, R15.1, R34.2
XIP_SCK: U4.52 (QSPI_SCLK), U9.6 (CLK)
XIP_SD0: U4.53 (QSPI_SD0), U9.5 (DI(IO0))
XIP_SD1: U4.55 (QSPI_SD1), U9.2 (DO(IO1))
XIP_SD2: U4.54 (QSPI_SD2), U9.3 (IO2)
XIP_SD3: U4.51 (QSPI_SD3), U9.7 (IO3)
XIP_~CS: R13.2, U4.56 (QSPI_SS_N), U9.1 (~CS)
~RESET: C36.1, J2.3, R32.2, SW2.2, U4.26 (RUN)

Notes on the sheet:
~D11/MOSI
~D8
AREF
D6 = POK2 D7 = POK3
VIN(max) = 2.048V
D19/A5
SPI0
+3.3V
VSENSE = 0.8V
D17/A3
EXTERNAL ADC, 12bit 300KSps
~{RESET}
D13/SCK
IOREF
DC/DC Power Regulators
~D5
D12/MISO
Selection of IN2 is disabled once +VBUS is above +5.5V. Only +5V will be presented to the output pin.
D15/A1
BOOT SWITCH - +3.3V Normal Boot mode - GND UF2 Boot mode
Raspberry PI Pico Microcontroller
>1.06V
GND
I2C1
UART0 RX
V_{ENA(TH)} > 1.25V
USB Power Delivery
IO Drive Strength be must set to 12mA for GPIO25
UART0 TX
+VBUS = 5.0V to 20.0V
DEBUG CONNECTOR
~D6
D19/SCL
~D3
I_{LIMIT} = 2.6A
~D10/SS
+5.0V
~D9
+3.3V DCDC Enabled at 4.5V +V_{BUS}.
+VIN
D1/TX
+5.0V DCDC Enabled at 7.0V +V_{BUS}.
D0/RX
Keep resistors close to IC
D18/A4
POWER LED's
Board USB Power Delivery Profiles (10Wmax) Profile 1: +5.0V, 2.0A => POK2 = OFF, POK3 = OFF Profile 2: +9.0V, 1.0A => POK2 = ON, POK3 = OFF Profile 3: +20.0V, 0.5A => POK2 = OFF, POK3 = ON
D14/A0
D18/SDA
D16/A2
