perc-sw/phyduino_pico/(commit log)

2026-05-04 Rev E files added
    [phyduino_pico-B_Cu.gbr, phyduino_pico-B_Mask.gbr, phyduino_pico-B_Silkscreen.gbr, phyduino_pico-Edge_Cuts.gbr, phyduino_pico-F_Cu.gbr, phyduino_pico-F_Mask.gbr, phyduino_pico-F_Silkscreen.gbr, phyduino_pico-In1_Cu.gbr]
2026-05-05 Added board datasheets to repository.
2026-05-05 Updated 3D model links and change PCB notes for better printing.
2026-05-30 Orginized directory structure for GitHub pages. Updated documentation.
    [phyduino_pico-B_Cu.gbr, phyduino_pico-B_Mask.gbr, phyduino_pico-B_Silkscreen.gbr, phyduino_pico-Edge_Cuts.gbr, phyduino_pico-F_Cu.gbr, phyduino_pico-F_Mask.gbr, phyduino_pico-F_Silkscreen.gbr, phyduino_pico-In1_Cu.gbr]
2026-05-30 Minor change to iBoM
    [phyduino_pico.kicad_sch]
2026-05-30 PCB fabrication output update.
    [phyduino_pico-B_Cu.gbr, phyduino_pico-B_Mask.gbr, phyduino_pico-B_Silkscreen.gbr, phyduino_pico-Edge_Cuts.gbr, phyduino_pico-F_Cu.gbr, phyduino_pico-F_Mask.gbr, phyduino_pico-F_Silkscreen.gbr, phyduino_pico-In1_Cu.gbr]
2026-06-09 Add pin-out diagram and updated ibom.
2026-06-09 Updated pin-out doc
2026-06-09 Corrected ref designator error
    [phyduino_pico.kicad_sch]
2026-11-01 Add .gitattributes KiCad writes LF line endings on every platform, but core.autocrlf=true checks text files out as CRLF on Windows. Saving or re-exporting the board, schematic, Gerbers, drill files o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
    Check these files out as LF so the working copy matches what KiCad
    writes.
